das-habitat/giesbert/README.md

# Sprechender Blumentopf [giesbert]

giesbert-logo

## Packages

* [Controller](./hardware/controller/README.md)
* [Server](./server/README.md)
* [Website](./website/README.md)

## Workshop

You can carry out the project at home or as a workshop at Habitat Augsburg e.V. You can find all the workshop dates here via this link: <https://das-habitat.de/elektronikkurs-fur-kinder-jugendliche-sprechender-blumentopf>.
