das-habitat/giesbert/docs/flyer/pumpe-freisteller.png

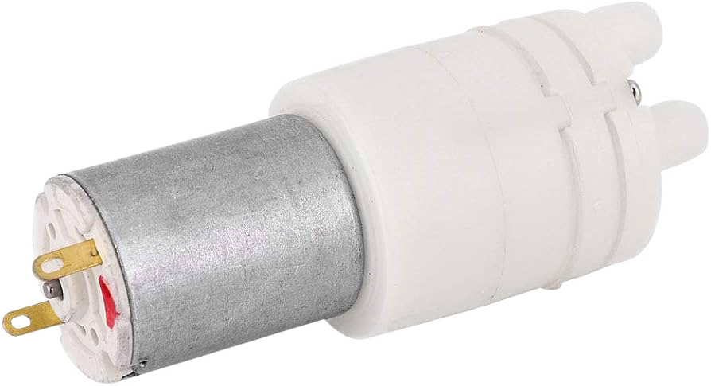
docs/flyer/pumpe-freisteller.png
