das-habitat/giesbert/docs/3d-prints/moisture_sensor_lid.stl

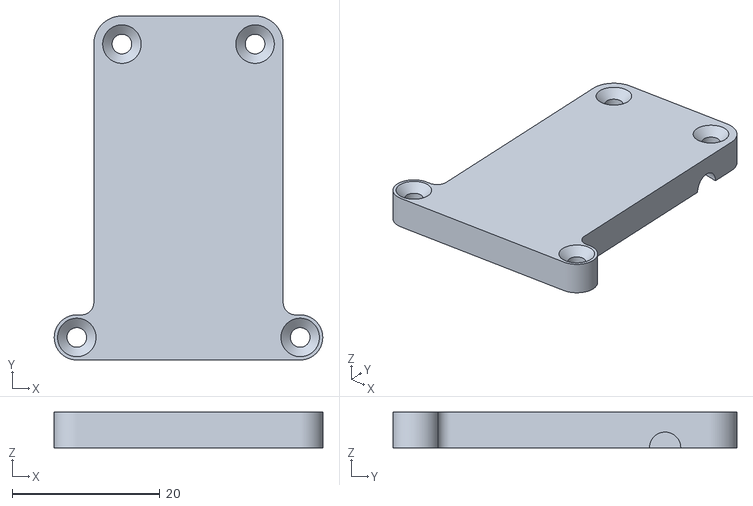
[picture p3: CAD file, 2026-10-05]
docs/3d-prints/moisture_sensor_lid.stl
36.3 x 46.5 x 4.80
