das-habitat/giesbert/docs/3d-prints/moisture_sensor_housing.stl

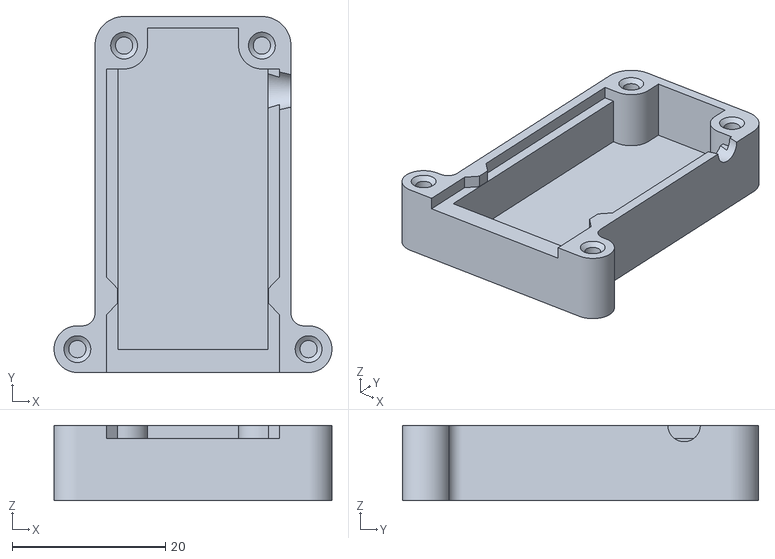
[picture p4: CAD file, 2026-10-05]
docs/3d-prints/moisture_sensor_housing.stl
36.3 x 46.5 x 9.80
