das-habitat/giesbert/TODO.md

# Workshop

## Wir messen Sensoren mit dem Multimeter

[ ] Multimeter erklären
[ ] Bodenfeuchte messen

## Sensorwerte am PC

### Einrichten

[ ] IDE installieren
[ ] Packages installieren (HttpClient, WifiManager)

### Messwerte loggen

[ ] use multimeter.h
[ ] Bodenfeuchtesensor kalibrieren

## Wir senden Messwerte übers Internet

[ ] use cloud.h
[ ] Variablen setzen
[ ] Notify erklären und Kanal abonieren
[ ] Dashboard
