das-habitat/giesbert/.archive/TODO.md

# Todo

- [ ] FE+BE: Types + Validation
- [ ] Docs: README.md + Beispiel-Code

- [ ] Notifications löschen
- [ ] Push Notification On/Off
- [ ] Messwerte ein/ausklappen
- [ ] Desktop-Layout

1. Redeploy (new caddyfile, deploy.sh etc.)
2. Arduino IDE + C --> VSCode + Rust

- [Embedded Rust setup #1](https://www.youtube.com/watch?v=TOAynddiu5M)
- [Embedded Rust setup #2](https://youtu.be/dxgufYRcNDg?t=467)
- [Microcontroller overview](https://www.youtube.com/watch?v=KzKw_483pbI)
- [ESP32 overview](https://www.youtube.com/watch?v=CfIjInYch7U)
