das-habitat/giesbert/(commit log)

2026-02-28 refactor: types and small fixes
    [giesbert.ino]
2026-10-05 docs: update
    [moisture_sensor_housing.stl, moisture_sensor_lid.stl]
2026-10-24 fix: avoid flooring voltages, power the sensor in moisture test and fix typos
2026-11-12 docs(handout): add image of the wired components
